michalroziel/oasis/esp32/info-esp.txt

we can use this tutorial : https://randomnerdtutorials.com/esp32-mqtt-publish-subscribe-arduino-ide/

Heres a Code tutorial with the same sensor as ours : https://youtu.be/pFQaFnqpOtQ?si=TmSWv2YcxZ1Cx1y0
