michalroziel/oasis/doc/graphics/IOT_Layers.png

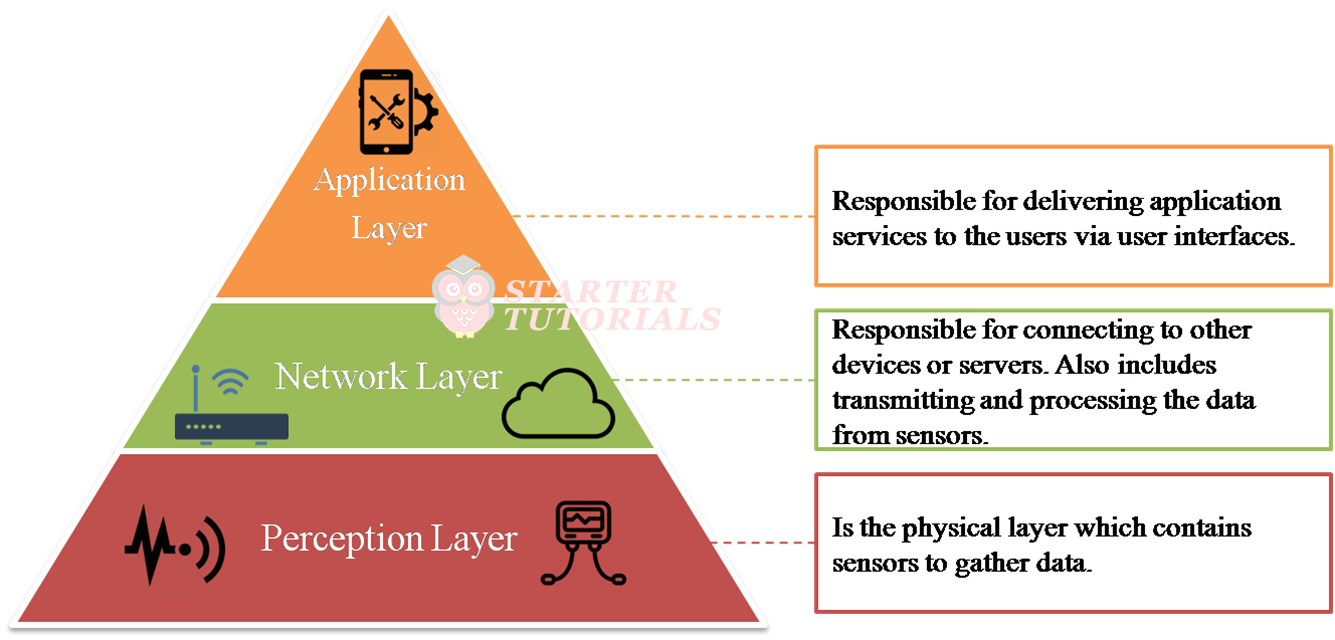
doc/graphics/IOT_Layers.png
