michalroziel/oasis/extra resources/20251211_22h20m42s_grim.png

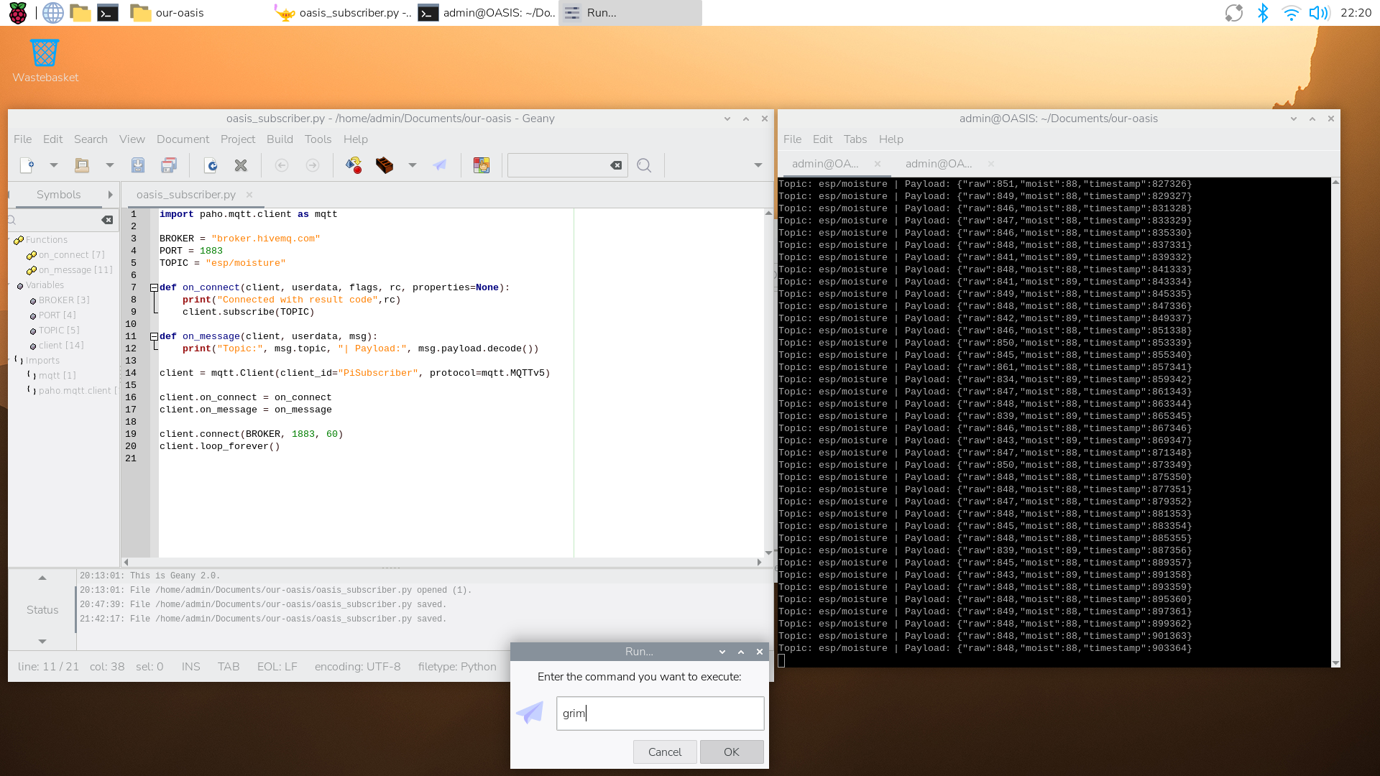
extra resources/20251211_22h20m42s_grim.png
