michalroziel/oasis/doc/graphics/oasis-test-export-1.png

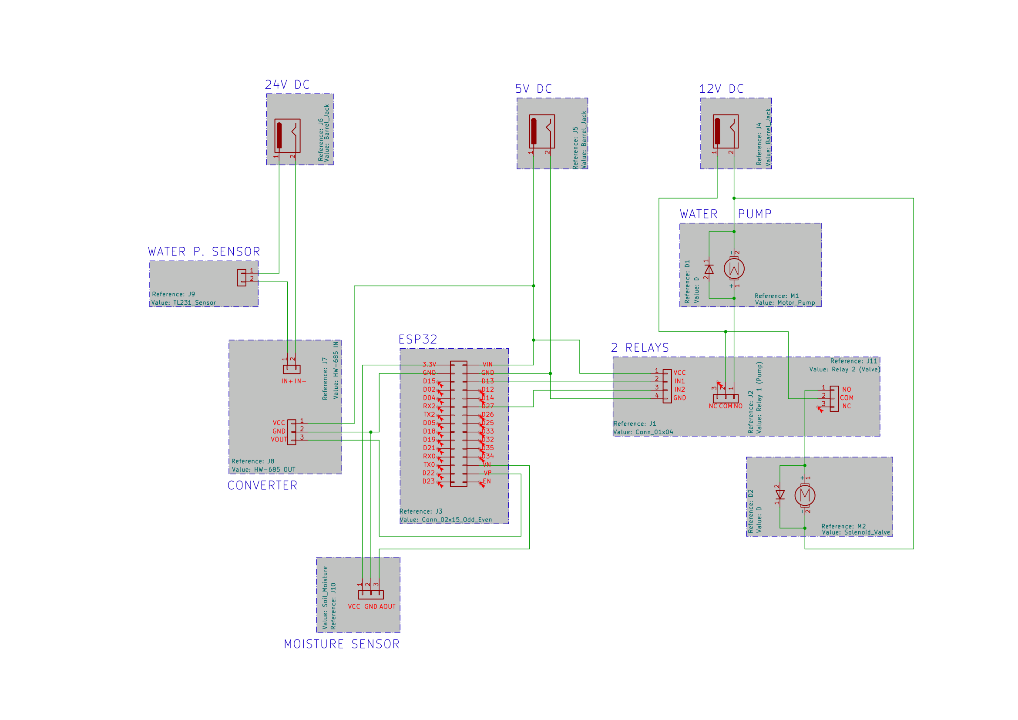
doc/graphics/oasis-test-export-1.png
