michalroziel/oasis/oasis-test-export.pdf

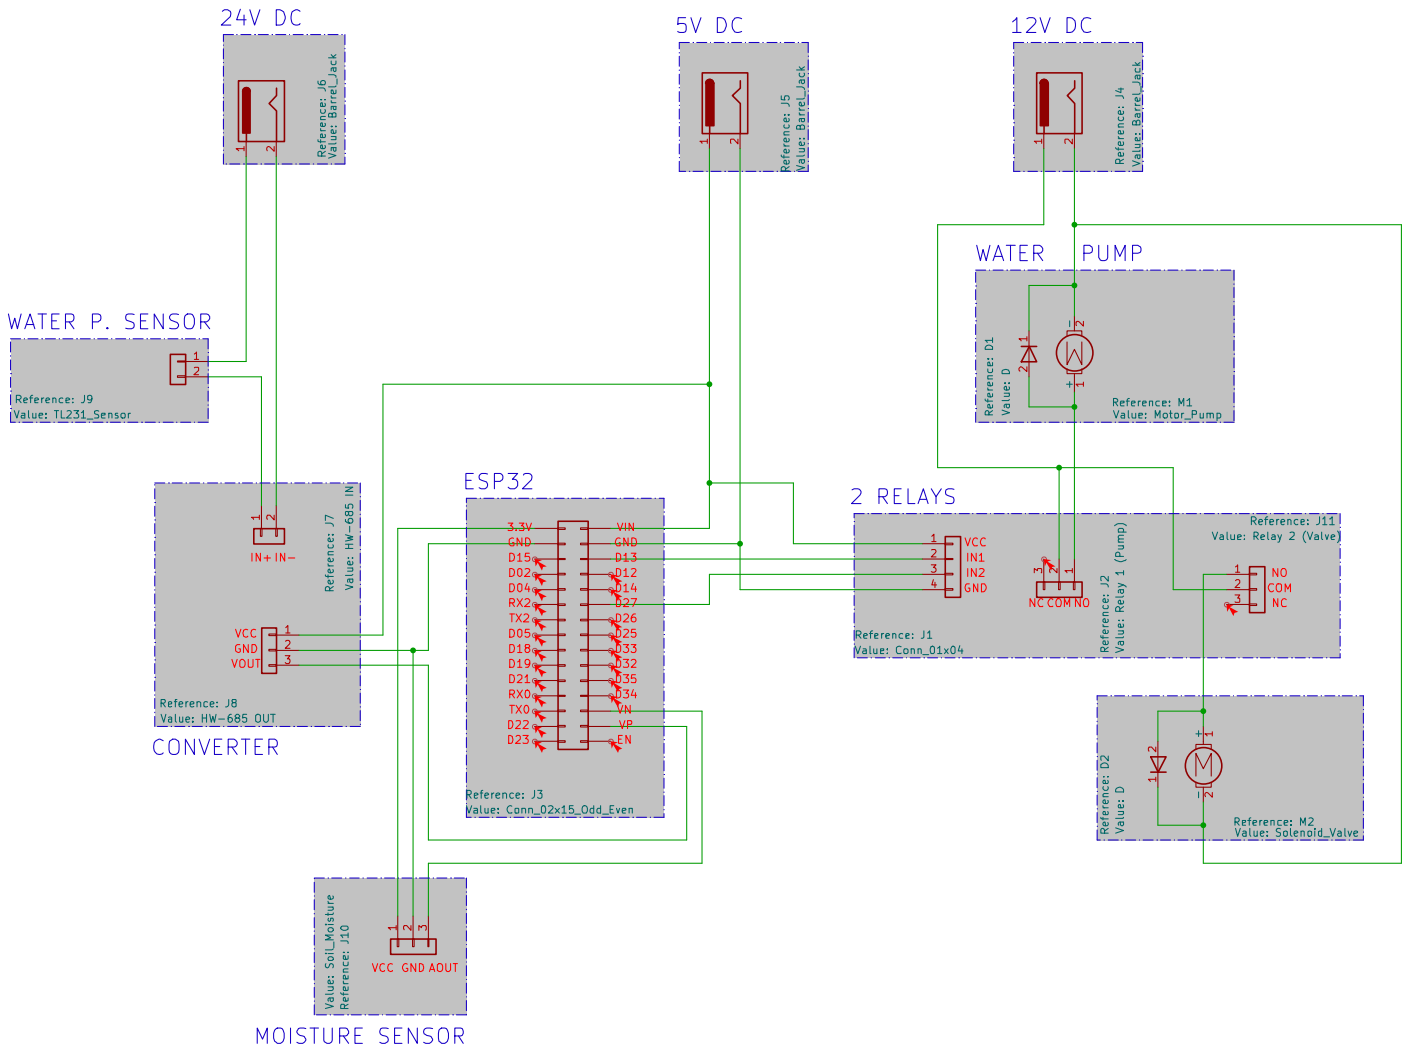
[picture p22: page 1]
