michalroziel/oasis/assets/oasis-schematic-v2 (1)_cropped.pdf

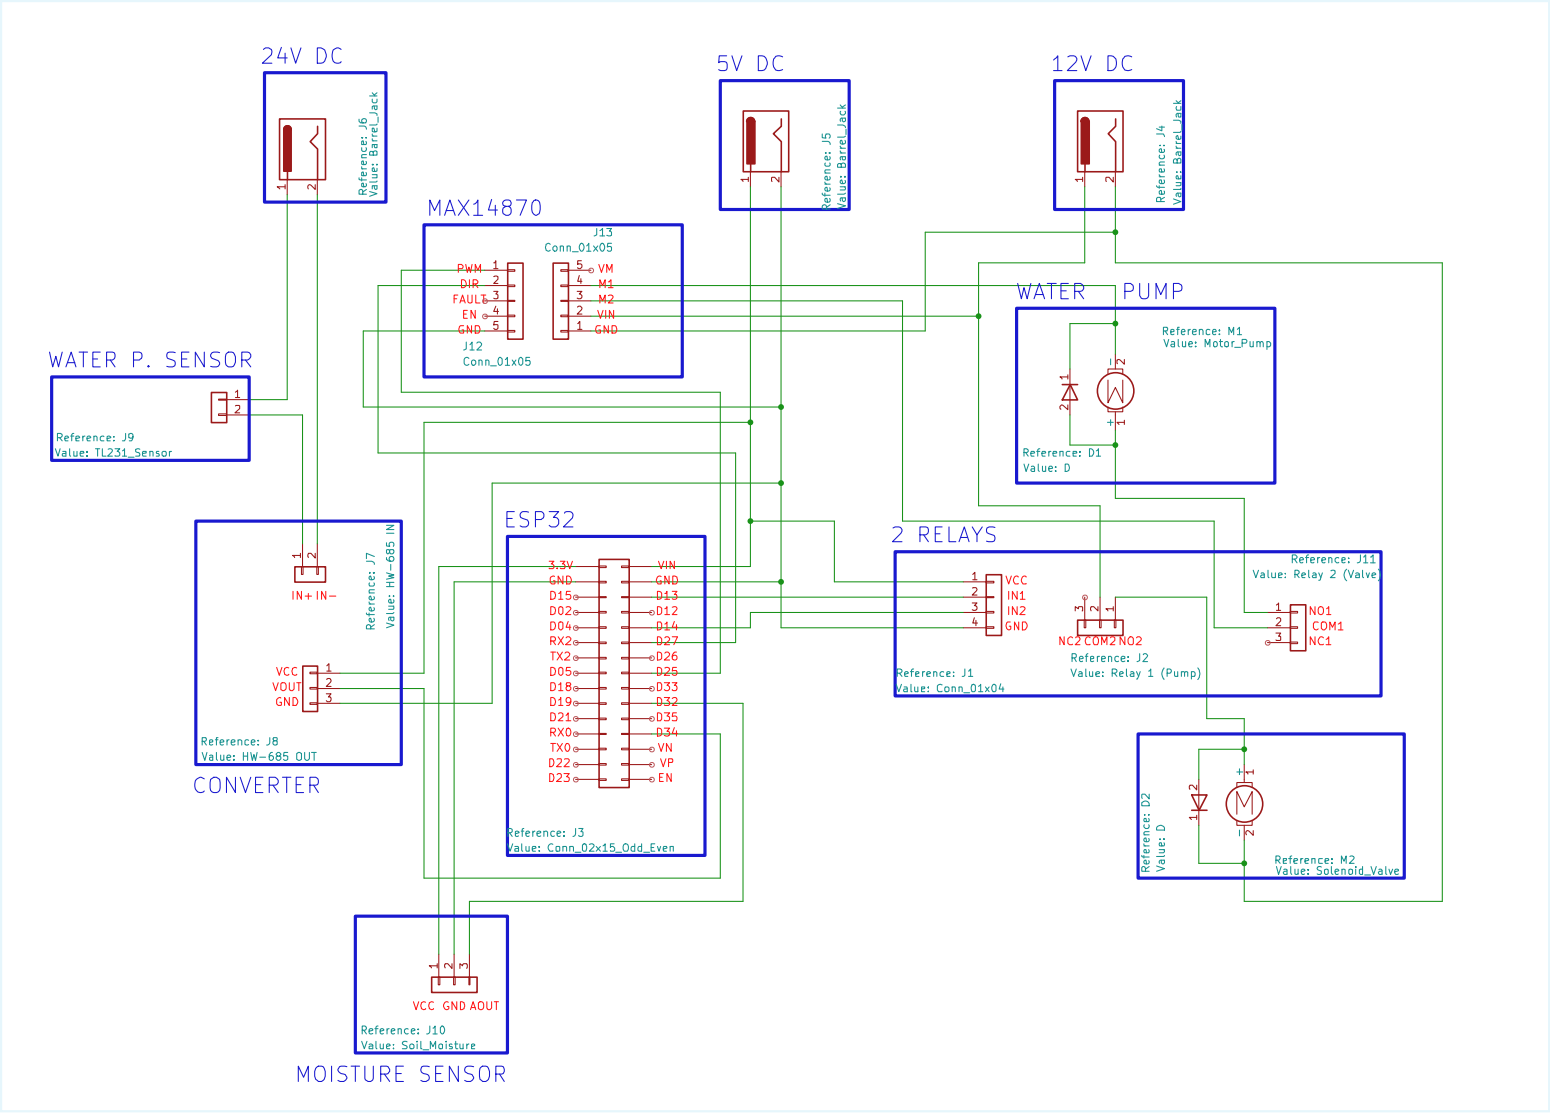
[picture p23: page 1]
