michalroziel/oasis/doc/oasis-schematic-v3.pdf

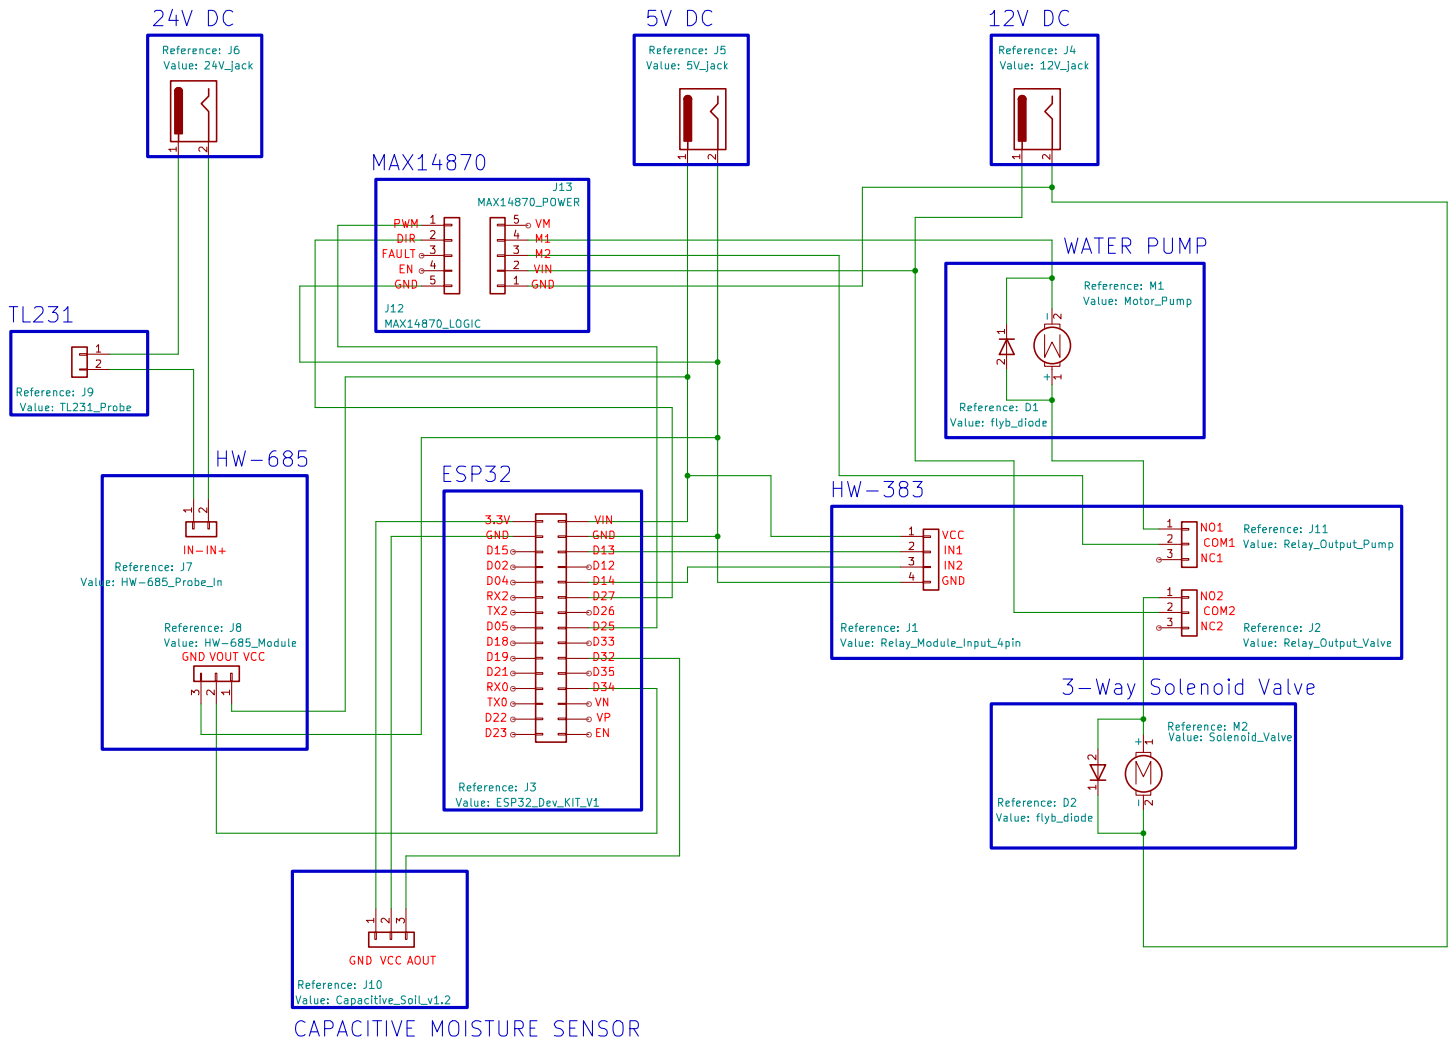
[picture p24: page 1]
