michalroziel/oasis/doc/graphics/dev-3.jpeg

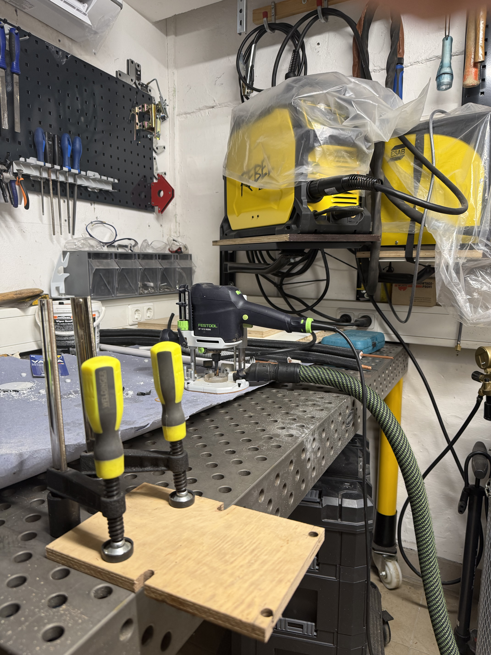
doc/graphics/dev-3.jpeg
