michalroziel/oasis/doc/graphics/dev-11.jpeg

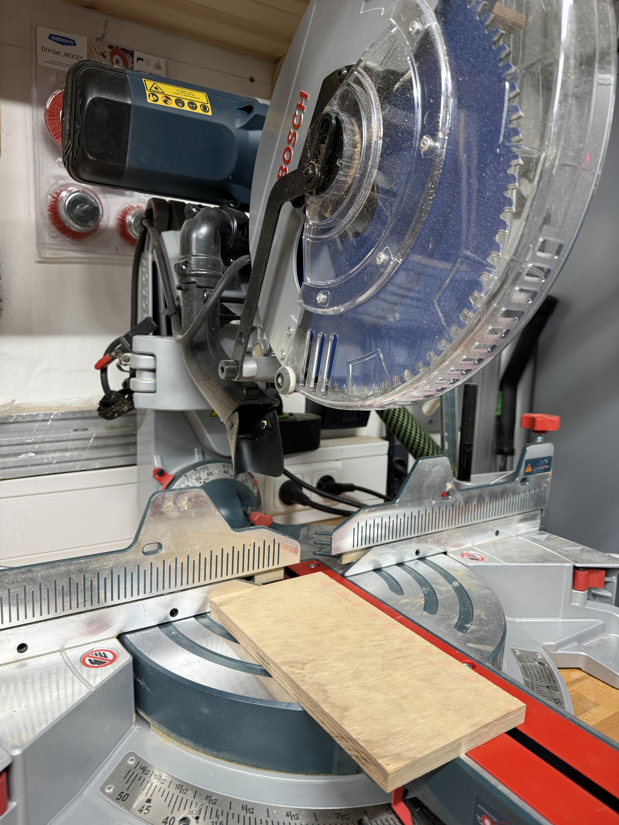
doc/graphics/dev-11.jpeg
