michalroziel/oasis/assets/graphics/dev-1.jpeg

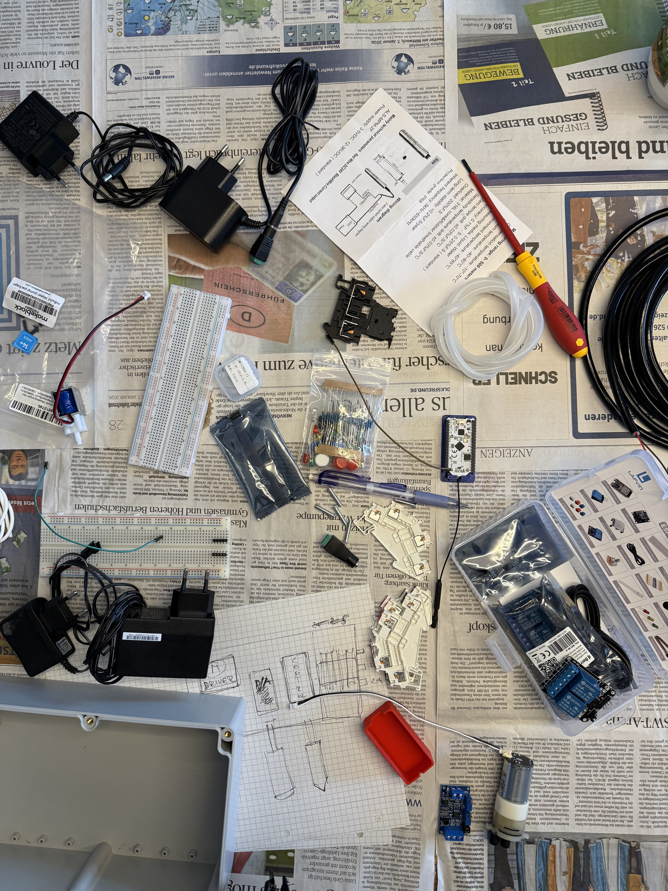
[picture p7: assets/graphics/dev-1.jpeg]
assets/graphics/dev-1.jpeg
