michalroziel/oasis/assets/graphics/dev-10.jpeg

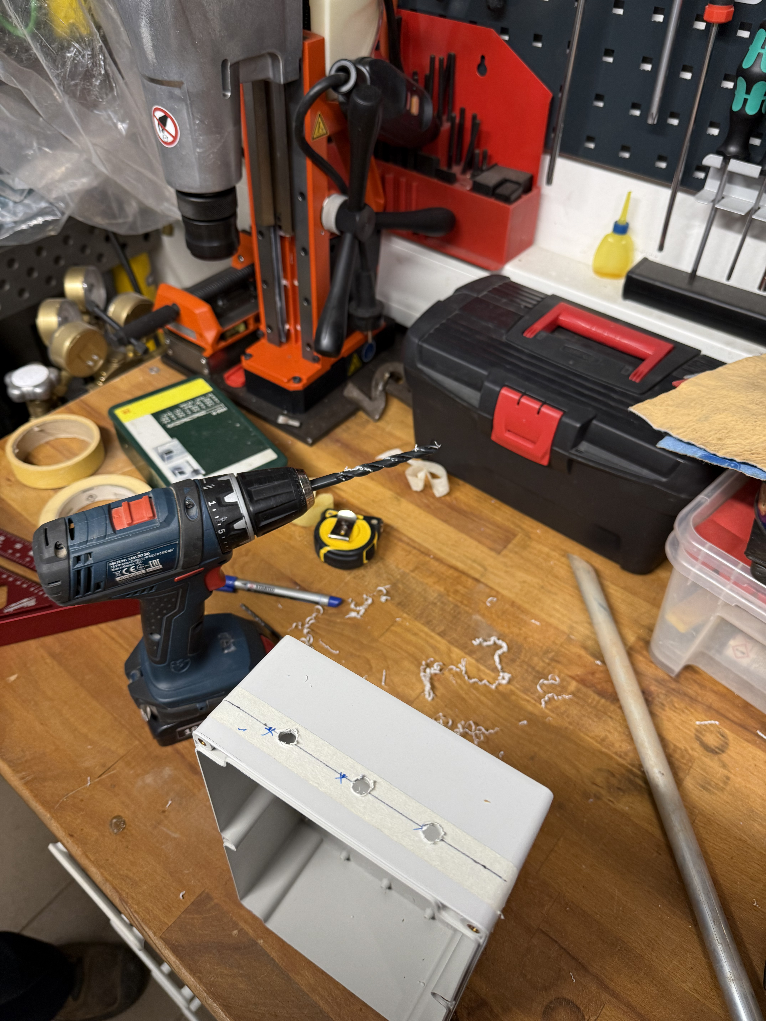
[picture p9: assets/graphics/dev-10.jpeg]
assets/graphics/dev-10.jpeg
