michalroziel/oasis/assets/graphics/dev-9.jpeg

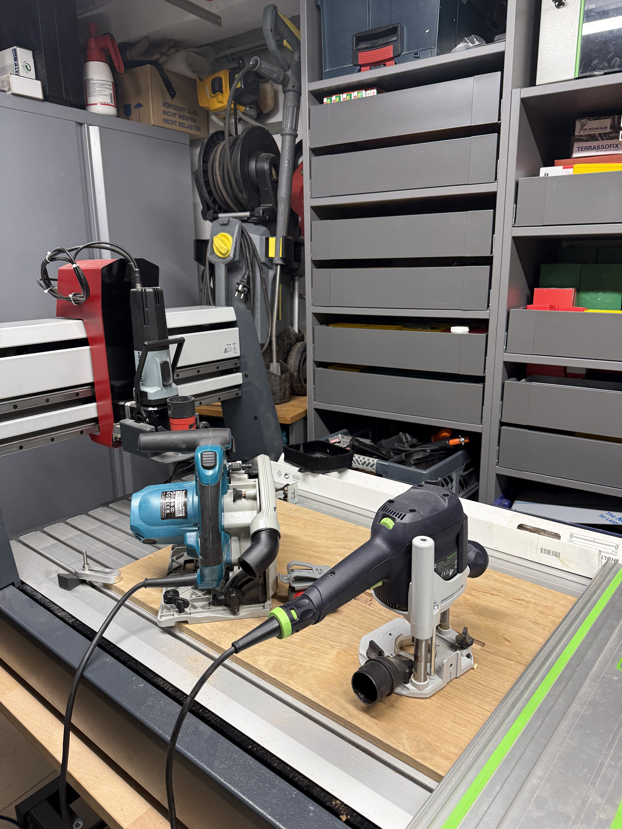
[picture p10: assets/graphics/dev-9.jpeg]
assets/graphics/dev-9.jpeg
