michalroziel/oasis/assets/graphics/dev-5.jpeg

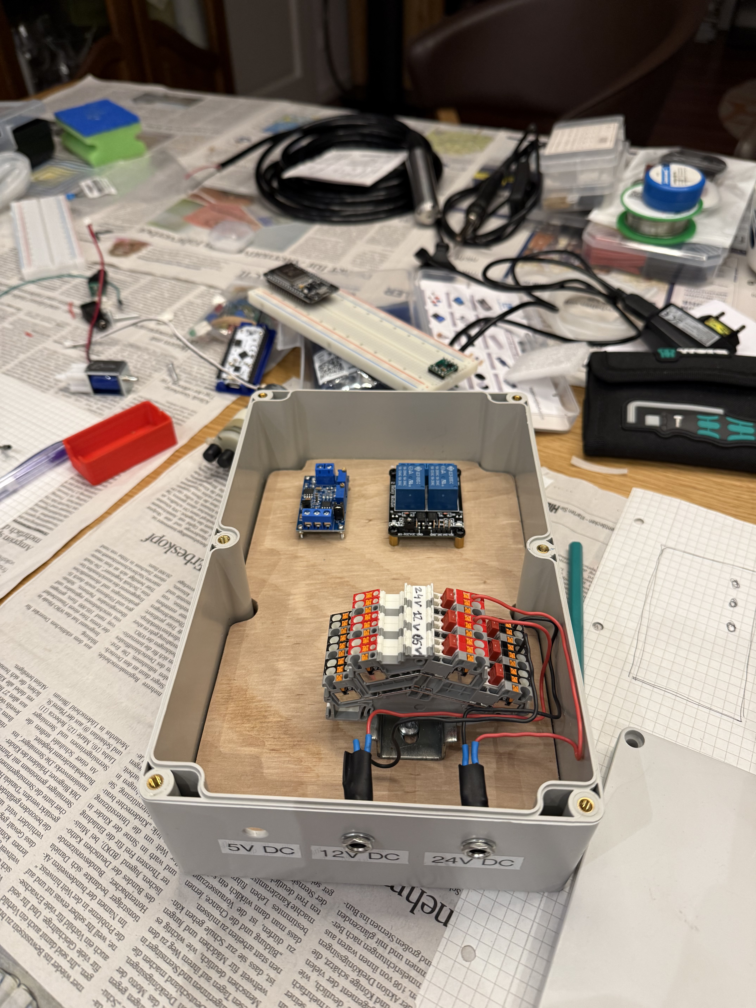
[picture p14: assets/graphics/dev-5.jpeg]
assets/graphics/dev-5.jpeg
